jaroslav-birdie/Radiopharmaceutical-pump/(commit log)

2026-06-05 Přidání CLAUDE.md s projektovou dokumentací a instrukcemi
    Obsahuje zapojení pinů, stavový automat, bezpečnostní pravidla ventilů,
    šablonu config.h a strukturu projektu pro radiofarmaceutickou pumpu.
2026-07-16 Oprava sémantiky ventilů, sjednocení Fáze 1 a rozšíření klávesnice
    - Trojcestné ventily nemají polohu "uzavřeno vůči všem" – 0° je reálně
    otevřená cesta, ne bezpečný klidový stav. Zavedena sémantika podle
    spojených portů (V/P/C u pacientského, S/V/F u vzduchového ventilu).
    - Fáze 1 sjednocena pro 10 ml i 20 ml variantu (tlačení vzduchu do
    dosažení kritické hladiny, s automatickým doplňováním vzduchu a
    bezpečnostním limitem počtu doplnění -> ST_ALARM_EXCESS_AIR).
    - Iterativní cyklus rozlišuje 1. iteraci (pevný počáteční objem vzduchu)
    a následující iterace (adaptivní objem podle předchozí spotřeby).
    - Dvoustupňové nouzové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
2026-07-22 Doplnění CLAUDE.md o hardwarové drivery, EEPROM a bezpečnostní konstanty
    - DRV8825: hardwarové zapojení MS1/MS2/MS3 pro 1/16 mikrokrokování.
    - Penicilinka 10 ml i 20 ml je fyzicky totožná lahvička (jen jiná náplň).
    - Doplňování vzduchu (refill loop) sjednoceno pro Fázi 1 i každou iteraci
    zvlášť, včetně kumulace naučeného objemu napříč doplněními.
    - Přejmenován MAX_PHASE1_AIR_REFILLS -> MAX_AIR_REFILLS (platí obecně).
    - Přidán NO_FLOW_TIMEOUT_MS (orientační, k doladění na prototypu) a
    CALIBRATION_DURATION_MS (10 s dle zadání).
    - Přidán rozsah jemné korekce objemu enkodérem (8-12 ml / 18-22 ml).
    - Přidána sekce EEPROM: ukládají se pouze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
2026-07-22 Kompletní firmware zařízení: stavový automat, drivery, Serial ovládání
    - config.h: všechny piny, úhly ventilů (EEPROM default), objemy, limity.
    - state_machine: celý aplikační proces (Fáze 1 sjednocená, 9 iterací
    s učením objemu vzduchu, refill smyčka s MAX_AIR_REFILLS, dvoustupňové
    nouzové zastavení PAUSE/STOP, hlídání stagnace hladiny s auto-resume).
    - servo_valve: serva přímo přes Timer1 HW PWM (D9/D10 = OC1A/OC1B),
    bez knihovny Servo, nulový jitter.
    - stepper: neblokující generování kroků z micros(), pause/resume,
    sledování polohy čítáním kroků.
    - capacitive: vlastní driver FDC1004 (REPEAT 100 S/s, 2 kanály,
    kalibrace průměrování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
    [Radiopharmaceutical-pump.ino, capacitive.cpp, capacitive.h, config.h, display.cpp, display.h, encoder.cpp, encoder.h]
2026-07-22 Přidání EN pinu krokových motorů, objasnění I2C sdílení
    - PIN_STEPPER_EN (A3): sdílený nENBL obou DRV8825, aktivní LOW.
    Firmware jej odpojuje (HIGH) při ST_EMERGENCY_STOP,
    ST_ALARM_EXCESS_AIR, ST_COMPLETE a ST_ERROR jako dodatečnou
    HW pojistku nezávislou na generování kroků.
    - Piny jsou nyní beze zbytku obsazené (18/18).
    - CLAUDE.md: doplněna poznámka, že OLED (0x3C) a FDC1004 (0x50) sdílí
    A4/A5 jako I2C sběrnici - to není konflikt, jen správné použití I2C.
    Kompilace bez warningů: flash 49.5 %, SRAM 30.2 %.
2026-07-22 Motory DISABLED před START, ENABLED po celý proces včetně PAUSE
    - Výchozí stav po zapnutí je DISABLED (dříve ENABLED) - obsluha v
    ST_WAIT_READY/ST_SET_VOLUME ještě ručně osazuje lahvičku a stříkačky.
    - enableSteppers() se volá právě jednou, přesně při stisku START
    (přechod do ST_CALIBRATING) - od té chvíle zůstává ENABLED po celou
    aplikaci, včetně ST_PAUSED (drží polohu pístu proti zpětnému tlaku).
    - DISABLED se vrací jen při ST_COMPLETE nebo STOP/ALARM/ERROR
    (beze změny oproti předchozímu commitu).
    - CLAUDE.md: doplněn přesný popis stavů ENABLED/DISABLED.
    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
    [state_machine.cpp, state_machine.h]
2026-07-22 Oprava: DISABLE motorů jen pro STOP a dokončení, ne pro ALARM/ERROR
    Předchozí commit chybně rozšířil disableSteppers() i na
    ST_ALARM_EXCESS_AIR a ST_ERROR. Jediné dvě situace, kdy motory smí
    přejít do DISABLE, jsou ST_COMPLETE (úspěšná aplikace) a
    ST_EMERGENCY_STOP (nouzové ZASTAVENÍ) - nikoli nouzové POZASTAVENÍ
    (ST_PAUSED) ani ALARM/ERROR, kde motory zůstávají ENABLED a drží
    polohu pístu proti zpětnému tlaku.
    Kompilace bez warningů: flash 49.4 %, SRAM 30.2 %.
    [state_machine.cpp]
2026-07-22 Provizorní testovací režim bez kapacitního senzoru (TEST_MODE_NO_SENSOR)
    Kapacitní senzor FDC1004 zatím není fyzicky osazen. Dokud tomu tak je,
    TEST_MODE_NO_SENSOR=1 v config.h nahrazuje detekci kritické hladiny
    pevně danými objemy vzduchu, beze změny zbytku architektury:
    - Fáze 1: 7 ml (10 ml lahvička) / 17 ml (20 ml lahvička, přes stávající
    refill smyčku - žádná strukturální změna, jen jiná podmínka ukončení).
    - Každá iterace: pevných 3 ml nasátí i vytlačení, adaptivní učení
    objemu (intakeMl_) je v tomto režimu vypnuté.
    - Hlídání stagnace hladiny (flowStalled) je vypnuté - bez svislé
    elektrody nemá vstupní data.
    - MAX_AIR_REFILLS, nouz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
2026-07-22 OLED: prodleva před inicializací, dvojité mazání, pomalejší I2C sběrnice
    Displej po zapnutí zobrazoval náhodný "šum" v GDDRAM (nikdy pořádně
    nesmazané piny mimo aktuálně vypisované řádky) - typický důsledek
    příležitostné I2C chyby při mazání/inicializaci, ke které dochází
    snáz na nepájeném/dočasném propojení a při vyšší sběrnicové rychlosti.
    - display.cpp: 100 ms prodleva před prvním I2C příkazem (čas na
    ustálení napájení/charge pumpy displeje), clear() se volá 2x při
    startu jako levná pojistka proti ojedinělému výpadku zápisu.
    - state_machine.cpp: I2C sběrnice zpomalena ze 400 kHz na standardních
    100 kHz - spolehlivějš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
2026-07-22 OLED: oprava skutečné příčiny šumu - roztříštěné vícebajtové příkazy
    Zpomalení I2C a prodleva při startu problém neřešily, protože šlo o
    firmwarovou chybu, ne o kvalitu spojení. Vícebajtové SSD1306 příkazy
    (0x21 Set Column Address, 0x22 Set Page Address - každý má 2 parametry)
    se posílaly bajt po bajtu, každý ve VLASTNÍ I2C transakci (STOP mezi
    každým bajtem). To přerušuje vnitřní stavový automat příkazu uprostřed:
    řadič čeká na parametr, ale dostane nový control byte místo něj, a další
    zápisy dat pak končí na neřízené/nečekané adrese v GDDRAM - navenek se
    to projeví přesně jako "náhodný šum" mimo poslední správně adresova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
2026-07-22 OLED: skutečná příčina byla SH1106 vs SSD1306, ne I2C framing
    Displej je SH1106, ne SSD1306 (potvrzeno uživatelem po diagnostice).
    SH1106 vůbec nezná příkazy 0x20 (Memory Addressing Mode) ani 0x21/0x22
    (Set Column/Page Address range), které jsou specifické jen pro SSD1306 -
    odesílání "opravené" i "neopravené" verze těchto příkazů tedy nemělo
    na výsledek žádný vliv, protože SH1106 jim vůbec nerozumí. Nábojová
    pumpa se navíc povoluje jiným příkazem (0xAD, ne 0x8D).
    - INIT_SEQ: 0x8D,0x14 -> 0xAD,0x8B; odstraněn nepoužitelný 0x20,0x00.
    - setWindow(): adresování po stránkách (0xB0-0xB7) + dvě "nibble"
    instrukce pro počáteční sloupec (SH1106 nemá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
2026-07-30 Přidání samostatného kalibračního sketche pro úhly ventilů
    tools/servo_calibration/servo_calibration.ino - dočasný, oddělený
    sketch pro experimentální určení úhlů PATIENT_VALVE a AIR_VALVE.
    Obě serva se současně otáčí po 5° krocích 0->180->0, s 2s prodlevou
    a výpisem aktuálního úhlu na Serial (9600 Bd).
    Serva jsou řízena stejně jako v hlavním firmware - přímo přes Timer1
    HW PWM (D9/D10), aby zjištěné úhly odpovídaly reálnému chování pumpy.
    Sketch je záměrně samostatný (bez závislosti na config.h/servo_valve.*
    hlavního projektu), aby šel nahrát bez nutnosti kopírovat soubory mezi
    sketchi. Po zjištění úhlů se zapíšou do config.h a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
2026-07-30 Rozšíření rozsahu serva o ~10° nad nominál (MG996R)
    Fyzicky potřebný úhel u jednoho ventilu přesahuje 180° o max. 10°.
    Servo (obousměrné/kontinuální) neumí "záporný úhel" opačným směrem -
    zvětšuje se proto SERVO_MAX_US (544->2503 us), takže logický rozsah
    0-180° zůstává v kódu beze změny, ale reálně pokryje o ~10° víc.
    Stejná hodnota upravena v config.h i v tools/servo_calibration, aby
    kalibrační sketch testoval přesně ten samý fyzický rozsah jako ostrý
    firmware. Při kalibraci ověřit, že servo u nového maxima nevrčí ani
    netáhne nadměrný proud (to by znamenalo skutečný mechanický doraz).
    Kompilace bez warningů: flash 49.1 %, SRAM 30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
2026-07-31 Oddělení objemu nasátí, prodleva na dotečení kapaliny, rychlejší nasávání
    - TEST_VOL_ITER_FILL_ML: objem nasátý zpět do stříkačky je nyní vlastní
    konstanta, nezávislá na TEST_VOL_ITER_PUSH_ML (dosud sdílely jednu).
    Obě nastaveny na 3,5 ml dle zadání.
    - FLUID_DRAIN_MS (5 s): po dotlačení vzduchu zůstane pacientský ventil
    otevřený, aby přetlak v lahvičce dotlačil kapalinu hadičkou. Teprve
    poté se ventil uzavírá (nová phase 7 v handlePushAir). Po PAUSE se
    prodleva odpočítá znovu celá - ventil se nezavře předčasně.
    - AIR_FILL_SPEED_FACTOR (2x): nasávání vzduchu zpět je rychlejší, nic
    se při něm netlačí do pacienta. StepperMotor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
2026-07-31 Prodleva EQUALIZE_TIME_MS i po nasátí vzduchu přes filtr
    Vzduchový filtr klade průtoku odpor - po dokončení nasátí (ST_P1_FILL_AIR
    i ST_ITER_FILL_AIR) se tlak ve stříkačce/hadičce ještě chvíli vyrovnává.
    Přidána nová phase 3 v handleFillAir(), která čeká stejnou dobu
    EQUALIZE_TIME_MS jako handleEqualize(), než se přejde k tlačení vzduchu.
    Kompilace bez warningů: flash 49.9 %, SRAM 30.6 %.
2026-07-31 VOL_SAL_TOTAL_ML na 60 ml dle skutečné stříkačky
    Sjednoceno s SAL_SYR_ML_PER_MM (60ml stříkačka) a ITER_COUNT=11.
    Potřeba: 3 ml (Fáze 1) + 11x3 ml (iterace) = 36 ml, k dispozici 60 ml -
    dostatečná rezerva, ST_ERROR z nedostatku roztoku už nehrozí.
    Aktualizovány i zmínky "30 ml" fyziologické stříkačky v CLAUDE.md
    a komentáři ve state_machine.cpp na odpovídajících 60 ml.
    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
2026-07-31 Oprava: prodleva na dotečení kapaliny chyběla při doplňování vzduchu
    FLUID_DRAIN_MS se dosud aplikovala jen při finálním dosažení cíle
    (ST_ITER_PUSH_AIR / ST_P1_PUSH_AIR). Pokud ale cíl přesáhne kapacitu
    jednoho zdvihu stříkačky (max. 7 ml při rezervě 3 ml z 10 ml), spustí
    se větev "doplnění vzduchu" - ta zavírala pacientský ventil OKAMŽITĚ,
    bez jakéhokoli čekání na dotečení kapaliny z právě proběhlého tlačení.
    Přidán příznak pushDone_, který rozlišuje, co následuje po prodlevě:
    dokončení (phase 4) nebo pokračování doplněním (phase 5). Obě větve
    teď procházejí stejnou fází 7 s FLUID_DRAIN_MS, než se ventil zavře.
    Kompilace be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
2026-07-31 Úvodní srovnání tlaku po kalibraci + prodloužení doběhu na 30 s
    - FLUID_DRAIN_MS 5 s -> 30 s. Doběh kapaliny po zastavení motoru je
    exponenciální s tau = R*V/P (odhadem 6-10 s dle objemu vzduchové cesty
    a odporu jehly), takže 5 s stihlo vytlačit jen ~40 % zadrženého objemu.
    30 s odpovídá 3-5 tau. Mrtvý objem ani průsvit jehly nelze v současné
    konstrukci zmenšit, proto tato cesta.
    - Nový stav ST_PURGE_AIR mezi kalibrací a Fází 1: vzduchový ventil projde
    všemi třemi polohami (S-V, S-F, V-F) a v každé setrvá PURGE_DWELL_MS
    (2 s). Postupně se propojí každá dvojice ramen, takže se stříkačka,
    hadičky i lahvička spolehlivě ustálí na atmos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
2026-07-31 Kompenzace stlačení vzduchu, návrat FLUID_DRAIN_MS na 5 s
    Prodloužení doběhu na 30 s se experimentálně neosvědčilo - přiteklo jen
    pár kapek navíc, takže deficit není jen otázkou času, ale trvale
    zadrženého objemu (stlačení vzduchového sloupce + poddajnost mechaniky).
    FLUID_DRAIN_MS proto zpět na 5 s.
    Místo toho zavedena AIR_PUSH_COMPENSATION_ML (2,0 ml), která se přičítá:
    - ke každému cílovému objemu tlačení vzduchu (Fáze 1 i iterace),
    - ke každému nasátí v iteraci (jinak by stříkačka na zvětšené tlačení
    nestačila a spustila by zbytečnou refill smyčku).
    Konstanty TEST_VOL_* tedy nově udávají požadovaný objem KAPALINY,
    přirážku vz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
2026-07-31 Oddělení kompenzace stlačení vzduchu pro Fázi 1 a iterace
    Sdílená AIR_PUSH_COMPENSATION_ML (2 ml) seděla na Fázi 1, ale v iteraci
    byla příliš velká - dává smysl, headspace je v obou situacích jiný (na
    začátku Fáze 1 malý objem vzduchu v lahvičce, u iterací ustálených ~6 ml).
    Rozděleno na AIR_PUSH_COMPENSATION_P1_ML (2,0 ml, ověřeno) a
    AIR_PUSH_COMPENSATION_ITER_ML (1,0 ml, DOLADIT - jen orientační snížení,
    čeká na potvrzení testem). Aplikováno na obou místech, kde se dřív
    používala sdílená konstanta: cílový objem tlačení (handlePushAir) i
    nasátí (handleFillAir) v iteraci.
    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
2026-07-31 Závěrečné vytlačení po posledním doplnění fyziologického roztoku
    Dosud procedura končila hned po posledním doplnění roztoku, takže tento
    objem zůstal v lahvičce neaplikovaný. Nově se po posledním doplnění
    projde ještě jednou EQUALIZE -> FILL_AIR -> PUSH_AIR a i tento objem se
    vytlačí pacientovi; teprve pak ST_COMPLETE.
    Implementace: handleAddSaline už nekončí procedurou, vždy pokračuje na
    ST_ITER_EQUALIZE. Ukončení se přesunulo do handlePushAir (case 6), kde
    se pozná iter_ > ITER_COUNT a další roztok se už nepřidává. Počet
    doplnění roztoku zůstává stejný (1x Fáze 1 + ITER_COUNT iterací), přibylo
    jen jedno vytlačení navíc - bilance roztok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
2026-07-31 Souběh doplňování roztoku a nasávání vzduchu (~15 s úspory na iteraci)
    Během ST_P1_ADD_SALINE / ST_ITER_ADD_SALINE je vzduchový ventil nově
    v S<->F a oba krokové motory běží současně: roztok teče do lahvičky,
    stříkačka zároveň nasává vzduch z atmosféry přes filtr. Obě větve jsou
    v této poloze ventilu oddělené (port V zaslepen), takže se neovlivňují.
    Úspora ~15 s na iteraci, tj. ~2,7 min za celou proceduru.
    Cena (odsouhlaseno): lahvička je po dobu doplňování uzavřená, takže v ní
    přechodně vzniká přetlak (~0,6 bar u 10ml lahvičky, u větších podstatně
    méně). Vypustí se hned v následujícím ST_ITER_EQUALIZE. Test těsnosti
    proběhne zá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
2026-07-31 Revert "Souběh doplňování roztoku a nasávání vzduchu (~15 s úspory na iteraci)"
    This reverts commit e00802f7d2d0d06ab553fbdf611ca8dea1ba27b4.
    [logger.cpp, logger.h, state_machine.cpp]
2026-08-07 Zaznamenání skutečného zapojení kapacitních elektrod (FDC1004)
    Snímací sestava je fyzicky osazena a připojena na I2C. Zapsáno přiřazení
    elektrod k kanálům:
    - CIN1 = kruhová elektroda kolem obvodu, hlídá kritickou (minimální)
    hladinu prudkým poklesem signálu
    - CIN2 = svislá elektroda, kontrola pohybu hladiny (detekce stagnace)
    - CIN3 = shield, plošné elektrody naproti sobě výš než CIN1
    Přiřazení CIN1/CIN2 odpovídá tomu, co už capacitive.cpp konfiguruje.
    Zaznamenán rozdíl: CIN3 se v kódu zatím vůbec nepoužívá, konfigurace
    shieldu chybí. Dále zaznamenán zatím NEPOTVRZENÝ nápad, že by CIN1 mohla
    hlídat dvě hladiny (horní i spodní hranu ele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
2026-08-07 Diagnostický sketch a plán pro odladění kapacitního snímání hladiny
    CLAUDE.md: CIN3 zapsán jako AKTIVNÍ shield. Doplněno zásadní upozornění
    k zapojení - aktivní shield se nebudí z pinu CIN3, ale z vyhrazených
    výstupů SHLD1/SHLD2 (CONF_MEASx žádnou shield volbu nemá). Stínění kabelů
    nesmí jít na zem: uzemněné stínění naváže kapacitu kabelu (~100 pF/m)
    přímo na vstup, což je nad rozsahem CAPDAC (max 96,9 pF).
    tools/capacitive_test/: samostatný diagnostický sketch, nezávislý na
    firmwaru čerpadla. Streamuje kapacitu všech kanálů v pF jako CSV,
    ovládání příkazy po sériové lince (auto/ruční CAPDAC, tare, test šumu
    se statistikou, volba vzo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
2026-08-10 Sladění testovacího sketche se skutečným zapojením shieldů
    Přepojeno na HW: plošné stínicí elektrody -> SHLD2, opletení všech
    koaxiálních kabelů -> SHLD1. CIN3 a CIN4 tím zůstávají nezapojené.
    SHLD1/SHLD2 jsou trvale buzené výstupy bez registrové konfigurace,
    takže software se jimi nezabývá a měřené kanály zůstávají jen dva.
    - capacitive_test.ino: zredukováno na 2 kanály (CIN1, CIN2), odpadl
    příkaz e<ch> pro zapínání kanálů, CSV má nově 5 sloupců. Přidána
    automatická kontrola: CAPDAC >= 25 vypíše varování, že stínění je
    nejspíš omylem na GND.
    - README.md: fáze 0 přepsána na skutečné zapojení, doplněn test
    účinnost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
2026-08-10 Přidat automatizovaný sweep test kapacitního senzoru
    Nahrazuje ruční plnění/vyprazdňování z Fáze C novým samostatným
    nástrojem, který ovládá fyziologický stepper (0,5 ml kroky, oba
    směry po odstranění zpětné klapky pro účely testu), čeká na
    ustálení signálu a zaznamenává >= 50 rychlých vzorků na hladinu.
    Claude-Session: https://claude.ai/code/session_01TGnTAsCrRpYcR9AMnmx1in
2026-08-10 Přidat nástroj pro opakovaný spojitý cyklus odsávání/doplňování
    Nový samostatný test doplňuje capacitive_sweep_test.ino: místo
    diskrétních kroků s čekáním na ustálení jede motor spojitě stejným
    tempem jako reálný provoz (5 s/ml) a měří průběžně. Automaticky
    opakuje ≥5 cyklů (odsaj cycleMl → doplň zpět → znovu), cílem je
    ověřit spolehlivost detekce hran (opakovatelnost, marže nad šumem),
    ne přesnou polohu. CIN2 slouží jen jako kontrolní signál pohybu.
    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
2026-08-10 Přidat pomocný skript pro logování sériové linky do souboru
    Diagnostické sketche v tools/ generují desítky tisíc řádků výstupu,
    což je nepohodlné kopírovat ručně z Arduino Serial Monitoru.
    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
2026-08-10 Přidat nástroj pro živou detekci hran s pauzou na kontrolu
    Na rozdíl od předchozích nástrojů (jen logují data) tenhle přímo běží
    navržený detekční algoritmus - vyhlazení 25 vzorků, pokles od
    průběžného maxima C1, potvrzení přes N vzorků - a motor se podle něj
    sám zastavuje. Fáze 1 hledá horní hranu, fáze 2 dolní/kritickou,
    mezi tím pauza na vizuální kontrolu obsluhou.
    Motor jen odsává, nikdy nedávkuje zpět - doplnění mezi cykly je
    ruční, mimo řízení systému, takže se nezávisí na známé počáteční
    hladině (jen na tom, že leží v rozmezí ~8-20 ml). Kvůli tomu
    odběr ze stříkačky kumuluje přes 5 cyklů - přidána kontrola
    maxSyr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
2026-08-10 Opravit falešnou detekci horní hrany - klouzavé okno místo maxima
    První test ukázal, že "maximum od začátku fáze" je zranitelné vůči
    pomalému driftu nesouvisejícímu se skutečnou hranou: šumový výkyv
    hned na začátku nastavil referenční maximum, a pomalý pokles
    rozprostřený přes ~9 ml pak i přes vyhlazení nastřádal dost na
    falešnou detekci "horní hrany" - výrazně dřív, než mohla fyzicky
    nastat. Chybný vrchol se pak zamkl jako reference pro fázi 2, která
    kvůli tomu nenašla dolní hranu vůbec.
    Referenční maximum se teď počítá jen z posledních referenceWindowMl
    (výchozí 5 ml, ~3,5x přes pozorovanou délku skutečného přechodu),
    ne od zač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
2026-08-10 Vynutit minWithdrawMl >= referenceWindowMl proti druhé falešné detekci
    Druhý test ukázal jiný problém než první: krátký "rozkolísaný" přechod
    (~0,07-0,10 pF) hned po rozjezdu motoru, uvnitř prvních ~3 ml. Klouzavé
    okno z předchozí opravy proti němu vůbec nezasáhlo, protože se teprve
    plnilo - dokud neuplyne aspoň referenceWindowMl, okno se chová stejně
    jako staré neomezené maximum (nic nezapomíná). minWithdrawMl byl
    nastavený níž (2 ml) než referenceWindowMl (5 ml), takže detekce byla
    povolená dřív, než okno stihlo začít cokoliv zapomínat.
    Sketch teď sám vynutí minWithdrawMl >= referenceWindowMl (výchozí
    zvednuto na 6 ml) a deltaUpper na 0.10 pF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
2026-08-10 Zjednodušit edge_detect_test na výhradně kritickou (dolní) hranu
    Po 3 nezávislých terénních testech se živá detekce horní hrany ukázala
    nespolehlivá - šumové výkyvy (~0,07-0,10 pF) srovnatelné s deltaUpper se
    vyskytují po celé délce stoupající fáze C1, ne jen na začátku, takže žádné
    ladění klouzavého okna/prahu problém nevyřešilo. Kombinace s CIN2 (svislá
    elektroda) nepomáhá - na datech z capacitive_cycle_test je C2 v místě
    skutečného vrcholu C1 hladká/monotónní bez jakékoli lokální události,
    protože nemá kruhovou geometrii se dvěma hranami jako CIN1.
    Nástroj teď dělá jedinou spojitou fázi: sleduje neomezené (ne klouzavé)
    maximum C1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
2026-08-11 Opravit sebe-oslepení kalibrace CIN2, když je rušení přítomné při ustálení (v8)
    Po druhém ostrém použití v7 selhal jeden cyklus z deseti. Diagnóza: dotek
    studny byl přítomný už během ustálení (ne až během odsávání). Kalibrace
    z v7 to nerozliší od legitimního zvýšeného okolního šumu - naměřila
    klidový strop 0,0424 pF (19x nad typickou hodnotou ~0,0023 pF z ostatních
    12 kalibrací téhož běhu) a spočítala z toho práh 0,106 pF. Když pak ruka
    během odsávání odešla, skutečné hodnoty (0,031-0,047 pF) už na tenhle
    nafouknutý práh nestačily - kritická hrana se vyhlásila předčasně
    (-11,63 ml místo očekávaných ~-17 ml). Kalibrace se tedy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
2026-08-11 Opravit falešná přerušení bez doteku: kalibrace CIN2 musí zahrnout i běžící motor (v9)
    Třetí terénní test ukázal regresi oproti v8 - cyklus se opakovaně
    přerušoval bez jakéhokoli doteku studny. Příčina: kalibrace prahu
    ochrany CIN2 probíhala výhradně během ustálení se ZASTAVENÝM motorem,
    ale prah se pak aplikoval i během aktivního odsávání. Samotný běžící
    krokový motor (vibrace/EMI z DRV8825 při mikrokrokování) je ale
    reálný zdroj šumu na CIN2, který klidová kalibrace vůbec nevidí -
    v logu hned po rozjezdu motoru vyskočil šum na 2,8x nad klidovou
    kalibraci ze stejného cyklu, což systematicky spouštělo falešné
    detekce.
    Oprava: settleB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
2026-08-12 Přidat test 1: odezva komory a elektrod po kompletním stínění
    Nový samostatný bench nástroj tools/capacitive_response_test - první
    krok revalidace kapacitního snímání po dokončení stínění (olovo
    uzemněné na GND FDC1004 + Cu kolem celé studny). Na rozdíl od
    capacitive_edge_detect_test žádnou hranu nehledá, jen opakovaně
    pohybuje fyziologickou stříkačkou o pevný objem tam a zpět a loguje
    syrová C1/C2 data - cílem je čistý přehled chování komory před
    návrhem nového prahu pro hledání kritické hladiny (test 2).
    Vychází z tools/capacitive_cycle_test (spojitý pohyb, opakované
    cykly), rozšířeno o:
    - dvě po sobě jdoucí varianty počátečního ob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
2026-08-13 Test 1: jeden souvisly beh misto dvou rucne prepojovanych fazi
    Puvodni Faze A (odsati 18 ml z rucne nalite "~20 ml" lahvicky) hranu
    prstence vubec nenasla - napric vsemi cykly C1 klesla max o 0.23 pF
    misto ocekavaneho >1 pF. Dve nezavisle, od oka odhadnute zalivky nejsou
    vzajemne porovnatelne v ml.
    Novy protokol: jedno naplneni, jedno tare, jedno 'g' spusti cely beh -
    velka faze (20 ml odber/doplneni), na poslednim cyklu se misto plneho
    doplneni vrati jen 10 ml, pak pokracuje mala faze (10 ml) kolem nove
    zakladny. level_ml je ted signovana odchylka od tare, ne odhad obsahu
    lahvicky.
2026-08-14 tools: přidat test 2 - opakovaná detekce kritické hladiny
    Bench sketch, který kritickou hladinu skutečně hledá algoritmem
    odvozeným z dat testu 1: klouzavý medián 25 vzorků z C1, sledované
    monotónně neklesající maximum od začátku odsávání, pokles o
    deltaCritical 0,22 pF potvrzený 5 vzorky. Na 20 cyklech testu 1
    tahle kombinace sepnula 20/20 s rozptylem 0,40 ml.
    Jeden pokus = settle (5 s, naplní mediánové okno) -> pull (do
    detekce nebo do vyčerpání maxPull) -> hold (obsluha potvrdí 1/0)
    -> refill (náhodných 5-15 ml jako reset). Opakuje se 20x, vzorkuje
    se ve všech fázích včetně čekání na obsluhu.
    Rušení se záměrně nedetekuje a nic nezastavuje - CI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
2026-08-14 Remove logging during hold phase
    During HOLD phase when waiting for user confirmation, remove continuous sampling.
    Reduces memory overhead and output noise - no changes to hladina occur while motor is stopped anyway.
    Flash: 16122 B (50.0%), SRAM: 627 B (30.6%)
    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
2026-08-14 docs: zapsat závěry analýzy detekce v iterativním protokolu
    Reinterpretace naměřených dat test 1 (fyziologický roztok, 10 cyklů) pod
    reálným iterativním protokolem: první vytlačení na kritickou hladinu, pak
    opakovaně doplnit VOL_SAL_ITER_ML a vytlačit zpět.
    Hlavní zjištění:
    - vrchol křivky C1 se do okna 3 ml vejde (sepnutí 2,53 ml pod vrcholem,
    9/10 cyklů), obnovený vrchol se od skutečného liší max o 3 fF
    - creep patky je reálný (-41,5 fF/iteraci, r = -0,91), ale sedí 2,5+ ml
    pod vrcholem, kam se protokol nedostane; pracovní úsek neplochne
    - zbytkový objem s počtem iterací neroste - práh měří pokles od maxima
    z téhož vytlačování, ne absol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
2026-08-14 tools: novy sketch simulujici skutecny aplikacni protokol
    capacitive_protocol_test - meri presne to, co pristroj opravdu dela,
    misto plnych 20ml zdvihu jako dosavadni nastroje:
    krok 0 (faze 1) : lahvicka 10 ml -> vytlacit na kritickou hladinu
    krok 1..12 : doplnit 3,0 ml -> vytlacit na kritickou hladinu
    Zavira posledni otevrenou diru v analyze zapsane v CLAUDE.md - ta musela
    plne zdvihy na iterace premapovat, protoze zadna data z uzkeho ~3ml pasma
    kolem vrcholu neexistuji. Klicova vystupni velicina je hloubka sepnuti pod
    vrcholem, ktera musi zustat pod doplnovanou davkou; sketch prekroceni hlasi
    primo za behu.
    Beh je zcela automaticky vcetne pocatecniho naplneni lahvicky - obslu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
2026-08-25 tools: protokolovy test vytlacuje kapalinu vzduchem misto odsavani
    Predchozi verze menila hladinu odsavanim strikackou roztoku - tvrdy,
    presny pohyb bez stlacitelneho clenu. Realny pristroj kapalinu vytlacuje
    vzduchem, takze mezi motorem a hladinou je stlacitelny sloupec a pohyb
    hladiny je pomalejsi, mekci a nelinearni vuci krokum. Detekce se musi
    osvedcit prave v tomhle rezimu.
    Rizeni pumpy (piny, uhly ventilu z EEPROM, poradi kroku, rezerva
    vzduchove strikacky, dobehy) prevzato 1:1 z state_machine.cpp.
    Zavazna pravidla ze zadani jsou vynucena strukturou kodu:
    - oba drivery zustavaji ENABLED po cely beh; DISABLE jen na konci nebo
    pri nouzovem zastaveni
    - do PIN_SAL_DIR se zapisuje je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
2026-08-25 tools: prikaz 'm' - stream syrovych vzorku pro diagnostiku ruseni
    Prvni terenni beh ukazal na CIN1 i CIN2 soucasne skoky mezi dvema
    hladinami (C2 ~1,0 pF, C1 ~0,16 pF) s prodlevou 0,2-2 s, a to i se
    stojicimi motory. 'n' vraci jen statistiku za 1,3 s, coz je kratsi nez
    doba setrvani v jednom stavu - bistabilitu proto nemusi zachytit.
    'm' loguje celou casovou radu obou kanalu az do 'x', bez jakehokoli
    pohybu motoru ci ventilu. Umoznuje porovnat drivery OFF/ON a zkouseni
    konektoru proti zaznamu.
    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
2026-08-25 tools: smazat vsechny testovaci skripty
    Sestava se po prestavbe chova jinak, nez na cem byly dosavadni testy
    vyladene - namerene konstanty i zavery z nich uz neplati. Testovani
    zacne znovu od nuly, proto se cely adresar tools odstranuje.
    Smazano vcetne build.sh, serial_log.py a servo_calibration - lze je
    obnovit z historie, pokud budou znovu potreba.
    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
2026-08-25 tools: test 1 - profil signalu pri vytlacovani vzduchem
    Prvni mereni nove serie. Ma odpovedet na jedinou otazku: existuje pri
    vytlacovani vzduchem na CIN1 rozpoznatelny prechod pres kritickou
    hladinu a jak je velky proti tlakovemu artefaktu.
    Sketch nic nedetekuje - zadny klouzavy prumer, prah ani ochrana proti
    ruseni. Loguje syrova data 20x/s (FDC1004 na 400 S/s, takze kazdy vzorek
    z cerstve konverze). Vyhlazeni i prah se vyberou az nad daty.
    Pet polo-automatickych cyklu: obsluha naplni penicilinku na 10 ml,
    skript protlaci 20 ml vzduchu rychlosti 1 ml/5 s, obsluha potvrdi
    prazdnou lahvicku. 20 ml je zamerny prebytek, aby bylo v datech videt
    i to, jak vypada signal, kdyz uz prochazi jen vz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
2026-08-26 docs: vyhodnoceni testu 1 - profil CIN1 pri tlaceni vzduchem
    Analyza 5 cyklu (20903 vzorku, 20 Hz, bez filtrace).
    Hlavni zavery:
    - kriticka hladina JE vzduchem detekovatelna, ale jako rampa
    -0,045 pF/ml (stabilni na +-5 %), ne jako zlom
    - prah na % poklesu nefunguje: prazdna lahvicka = jen 10-14 %,
    CAP_CRITICAL_PERCENT 15 se nespusti nikdy
    - sum neklesa jako 1/sqrt(N) (1/f), delsi filtr nepomaha
    - zpomaleni tlaceni rozliseni nezlepsi
    - sum nepochazi z krokoveho motoru, ale z kapaliny
    - dobeh po stopu (7-15 s, ~2 ml) je vetsi nez chyba detekce
    - faze d/o tlakovy offset nezmerila - chyba navrhu testu
    Claude-Session: https://claude.ai/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
2026-08-26 tools: test 1 - vychozi napln vzduchu l10 misto l7
    Puvodni l7 delalo dve doplneni presne na 7 a 14 ml - jedno primo na
    zacatku rampy, druhe tesne pred jejim koncem, obe uprostred casti
    dat, ktera je nejzajimavejsi pro detekci sklonu.
    S l10 (cela strikacka na jednu naplni) je doplneni jen jedno, pri
    10 ml, a vznikaji dva souvisle useky bez preruseni: 0-10 ml (plato
    i zacatek rampy) a 10-20 ml (zbytek rampy i podlaha).
    Uplne mimo pasmo 5-15 ml se doplneni dostat nemuze (strikacka ma
    kapacitu 10 ml a startuje plna, takze prvni doplneni nemuze nastat
    pred 10 ml at je l nastaveno na cokoli) - README nove vysvetluje
    proc a co presne l10 rozdeleni useku zlepsuje.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
2026-08-26 tools: pridat rucni sweep uhlu vzduchoveho ventilu
    Novy diagnosticky sketch pro overeni skutecne fyzicke geometrie
    vzduchoveho ventilu (D10) - ktere 2 ze 3 ramen (S/V/F) jsou spojene
    v ktere poloze serva. Duvod: AIR_VALVE_SYRINGE_TO_FILTER_DEFAULT
    a AIR_VALVE_VIAL_TO_FILTER_DEFAULT v config.h jsou zatim jen
    provizorni odhady, ne overena kalibrace, a analyza testu 1 ukazala
    na moznost, ze jsou prohozene.
    Otoci servo po 5° krocich CW 0->180, pak CCW 180->0, v kazde poloze
    ceka na potvrzeni obsluhou (bez casoveho limitu) - da se tak
    porovnat i pripadnou vuli/hysterezi mezi najizdenim zleva a zprava.
    Zadny krokovy motor, zadny senzor - jen servo pres stejny Timer1
    HW PWM prevod jako ostry firm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
